Nitrokey/nitrokey-fido2-hardware/fabrication/Assembly/3D_BOT_Fido2.PNG

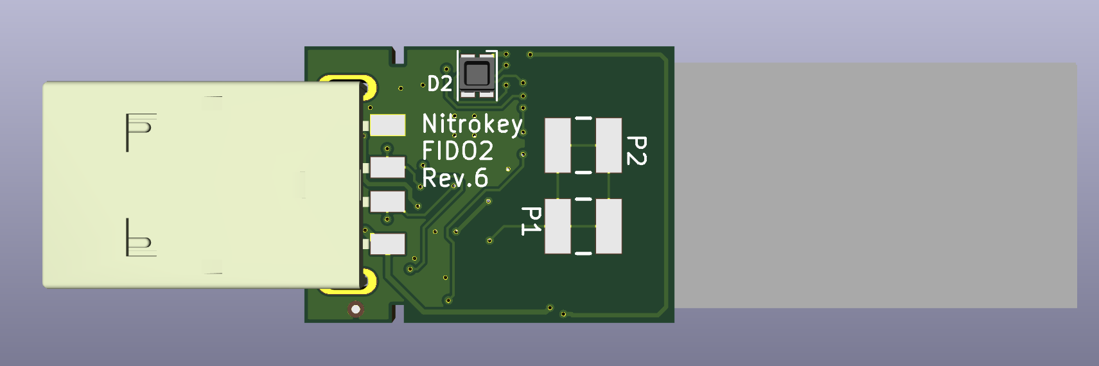
fabrication/Assembly/3D_BOT_Fido2.PNG
