Nitrokey/nitrokey-fido2-hardware/README.md

# nitrokey-fido2-hardware
Hardware layout of the Nitrokey FIDO2

- [nk-fido2-schematic.pdf](https://github.com/Nitrokey/nitrokey-fido2-hardware/blob/master/nk-fido2-schematic.pdf)
- [testpoints](Testpoints.png)

This project is licensed under [CC BY-SA 4.0](https://creativecommons.org/licenses/by-sa/4.0/)
