Nitrokey/nitrokey-fido2-hardware/fabrication/Assembly/nk-fido2-BOM.xlsx

FIDO 2 - BOM:
ID | Quantity | Designator | Footprint | Bezeichnung | Anbieter und Referenz | Comment
1 | 3 | C1,C4,C7 | C_0402_1005Metric | 4.7uF, Tolerance: +/- 10%
2 | 3 | C2,C3,C6 | C_0402_1005Metric | 0.1uF, Tolerance: +/- 10%
3 | 1 | C5 | C_0402_1005Metric | 10n, Tolerance: +/- 10%
4 | 1 | D2 | LED_Cree-PLCC4_2x2mm_CW | CLMVC-FKA-CL1D1L71BB7C3C3 | CLMVC-FKA-CL1D1L71BB7C3C3 (https://www.digikey.de/product-detail/de/cree-inc/CLMVC-FKA-CL1D1L71BB7C3C3/CLMVC-FKA-CL1D1L71BB7C3C3CT-ND/9094273)
5 | 1 | J1 | USB-A-PLUG | USB_Plug | ‎0480372200‎
6 | 1 | L1 | REG_NCP114AMX330TCG_21 | NCP114AMX330TCG | ‎NCP114AMX330TCG‎
7 | 1 | L2 | COIL2_26 | MOLEX_NFC_COIL_1462360101 | 1462360101 | nicht bestücken!
8 | 1 | R2 | R_0402_1005Metric | 10K, Tolerance: +/- 5%
9 | 2 | R3, R7 | R_0402_1005Metric | 4K7, Tolerance: +/- 5% |  | nicht bestücken!
10 | 1 | R4 | R_0402_1005Metric | 68R, Tolerance: +/- 5%
11 | 2 | R5,R1 | R_0402_1005Metric | 4K7, Tolerance: +/- 5%
12 | 1 | R6 | R_0402_1005Metric | 1M, Tolerance: +/- 5%
13 | 1 | U1 | QFN-32-1EP_5x5mm_P0.5mm_EP3.45x3.45mm | STM32L432KCUx | ‎STM32L432KCU6‎
14 | 1 | U2 | SOT-23-6 | MTCH101 | MTCH101-I/OT‎
15 | 1 | U3 | SOT-553 | DF5A5.6JE | DF5A5.6JE,LM‎
16 | 1 | U4 | UDFN-8Pad | ATECC608A |  | nicht bestücken!
17 | 1 | U5 | MLPD3X3_24 | AS3956 | AS3956-ATDM-S4‎ | nicht bestücken!
18 | 2 | P1,P2 | WE-SMGS_3029040030030 | Würth – 3029040030030 | Würth – 3029040030030
