Nitrokey/nitrokey-fido2-hardware/3DLib/CLMVC-FKA-CL1D1L71BB7C3C3.STEP

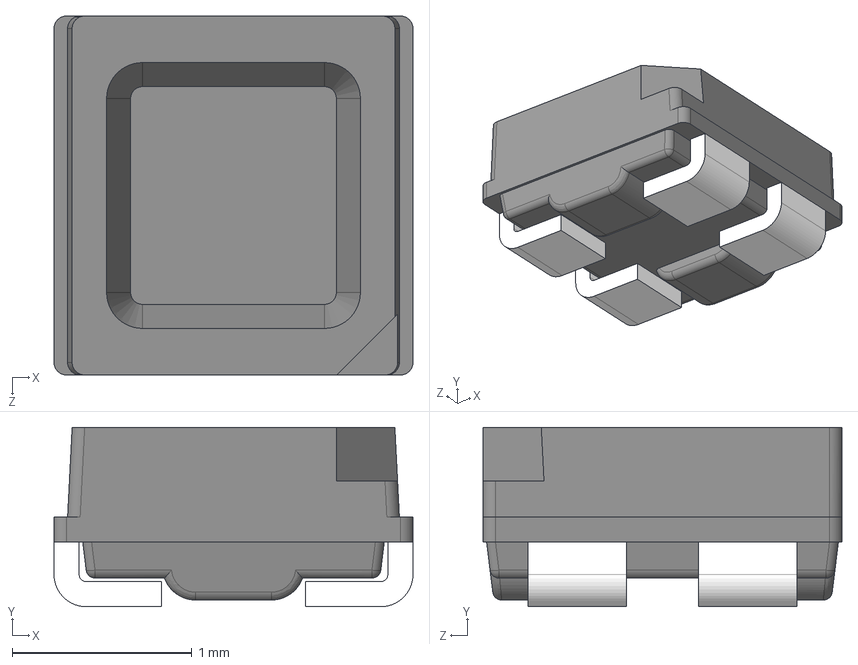
[picture p3: CAD file, 2019-10-14]
3DLib/CLMVC-FKA-CL1D1L71BB7C3C3.STEP
2.00 x 1 x 2.00 mm
