Nitrokey/nitrokey-fido2-hardware/3DLib/1462360101.stp

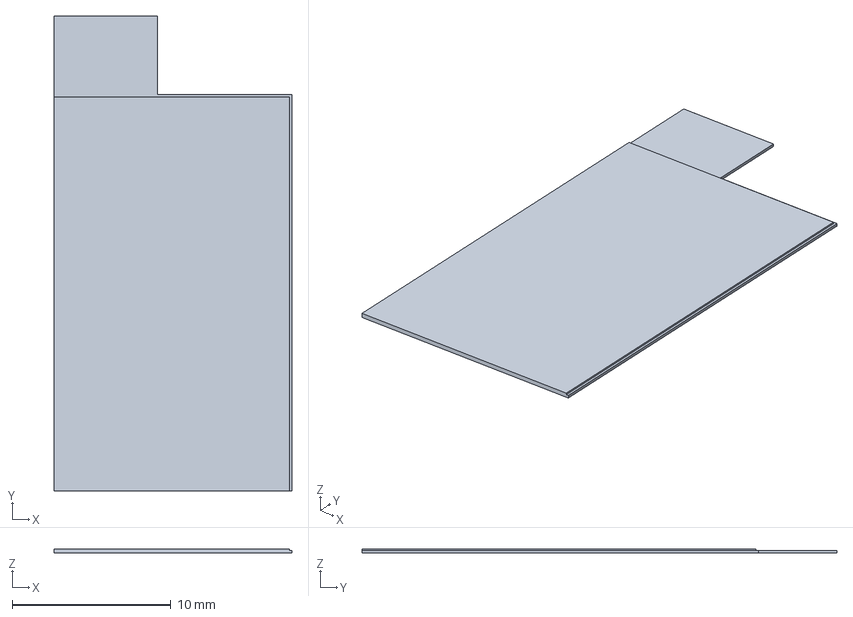
[picture p4: CAD file, 2019-02-20]
3DLib/1462360101.stp
15.0 x 29.9 x 0.27 mm
