Nitrokey/nitrokey-fido2-hardware/nk-fido2-schematic.pdf

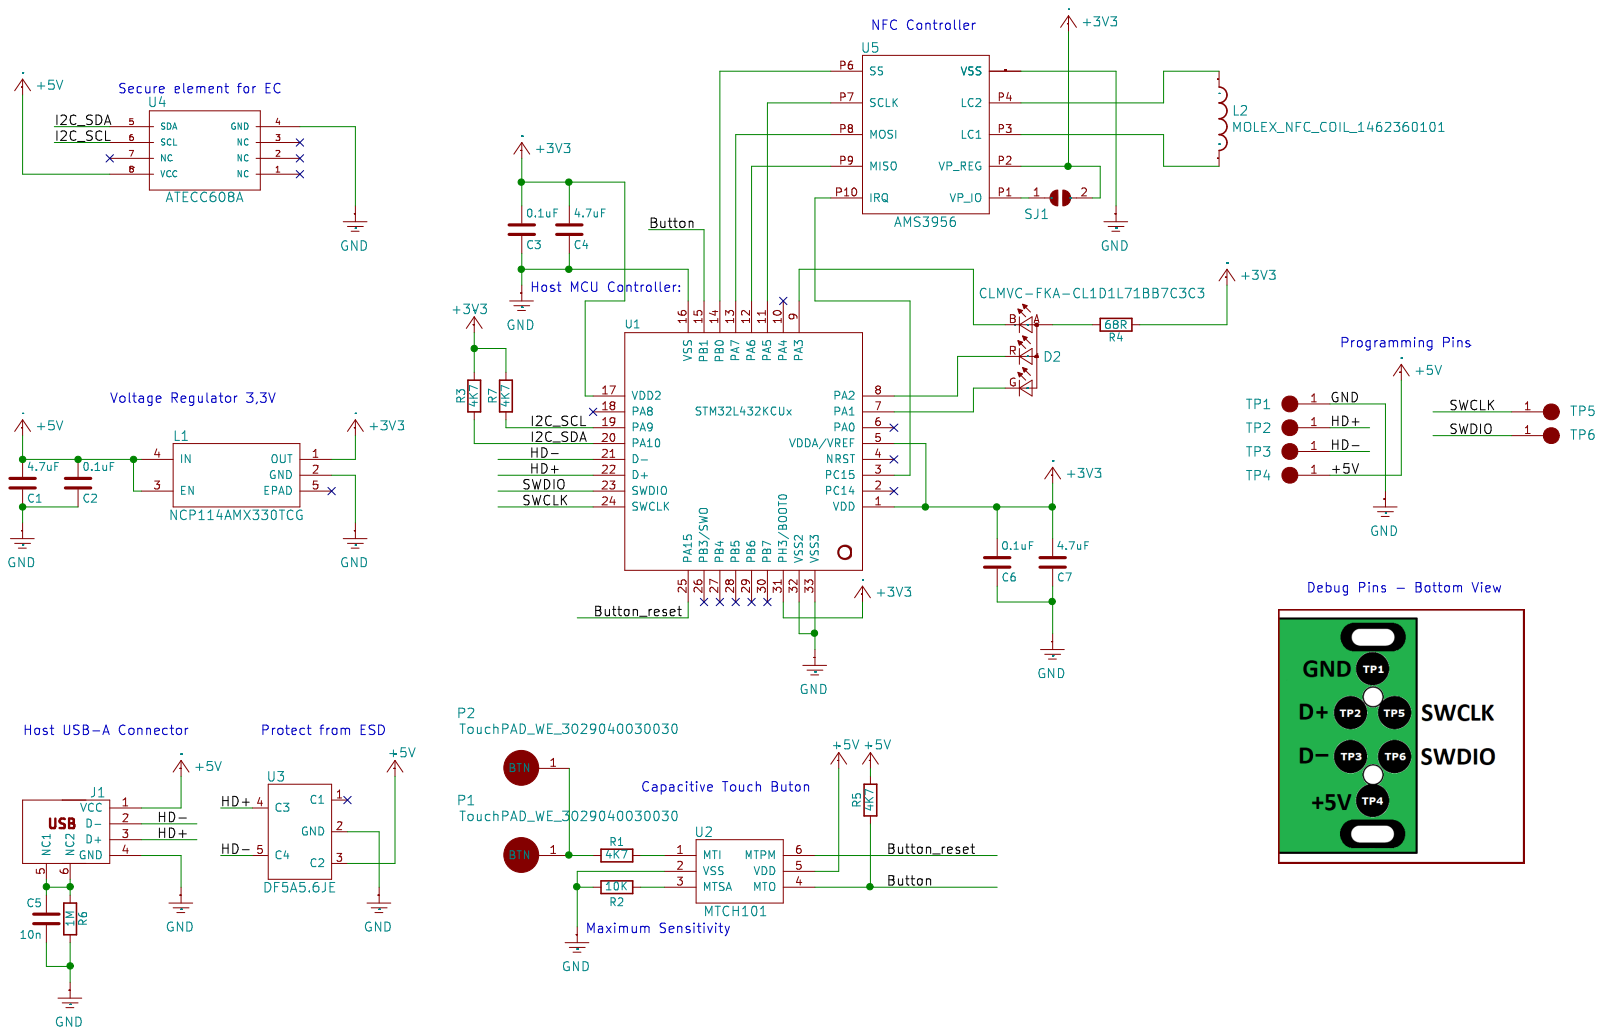
[picture p5: page 1]
