Nitrokey/nitrokey-fido2-hardware/fabrication/Assembly/nk-fido2-Assembly_TOP.pdf

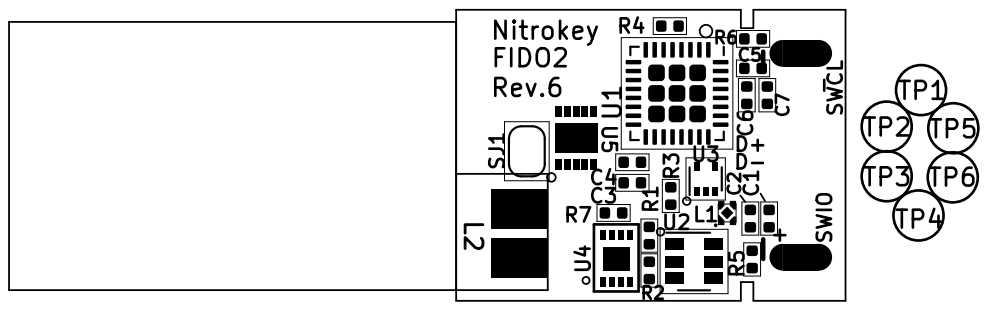
[picture p6: page 1]
