Nitrokey/nitrokey-fido2-hardware/Testpoints.png

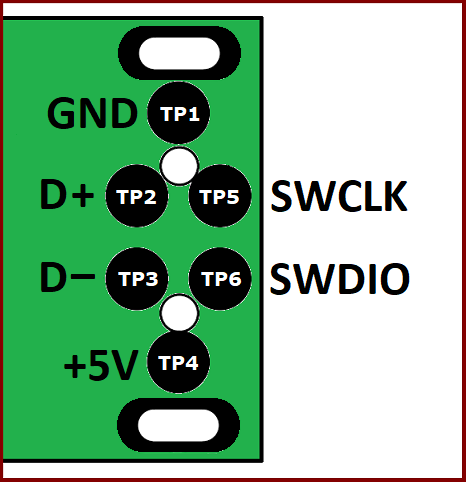
Testpoints.png
