Nitrokey/nitrokey-fido2-hardware/(threads)

Thread 3 (2019-03-29):

Move Pin 1 marking of RGBA LED to proper position

NKelias, 2019-03-29:
Pin 1 Marking on the PCB is currently on the position of Pin 4 on the package.
Alternatively, the anode mark between Pins 1 and 3 on the package might be used as well for alignment.

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

Datasheet: https://everlightamericas.com/index.php?controller=attachment&id_attachment=1010

jans23, 2019-04-12:
Fixed in revision 2.

Closed 2019-04-12.

Thread 4 (2019-03-29):

Correct self-inducement of the touch button

szszszsz, 2019-03-29:
At the moment there is a chance, that the touch button press state would be induced by the blinking of the LED. LED, and/or its power lines, seem to be too close to the touch button plane, thus influencing it. When confirmed with the manual of [MTCH101] (page 9, 7.0 DETECTION DISTANCE), there is this statement:
> No ground plane was near the sensor, as this would give the maximum
detection distance.

At the moment this is worked around in the firmware, by increasing the touch button activation time to 1000 ms (from 500 ms).

Possible solutions:
- moving the LED,
- moving LED's power lines,
- decreasing the size of the touch button plane (optionally moving it to side).

------

Another opinion:
> The datasheet says metal components placed closed to the sensing area could cause this
effect. Actually, touch devices generally requires a "clear" space all
around the sensing area. It means no any metal component should be
closer than a few millimeters, so it is true even for the copper tracks
and therefore the gnd plane. (...)  This can be solved by both hw and sw. The
hw way means a new layout design following the capacitive design
criterias.

[MTCH101]: https://github.com/Nitrokey/nitrokey-fido-u2f-hardware/blob/master/datasheets/Microchip%20MTCH101.pdf

jans23, 2019-04-12:
Hopefully fixed in revision 2. Should be reopened if it still occurs.

Closed 2019-04-12.

Thread 5 (2019-03-29):

Introduce MTPM reset pin to the MCU

szszszsz, 2019-03-29:
Introduce pulled-up MTPM reset pin from the touch controller, to allow the touch button reset from the firmware. Make sure the MTPM is correctly pulled-up (to proper voltage), to avoid noise.

Connected: #4

jans23, 2019-04-12:
Fixed in revision 2.

Closed 2019-04-12.

Thread 7 (2019-09-10):

Wrong LED orientation in 3D view

jans23, 2019-09-10:

jans23, 2019-10-14:
Fixed with commit c38ef88.

Closed 2019-10-14.
