Nitrokey/nitrokey-fido2-hardware/(commit log)

2019-02-20 initial release
    [1462360101.stp, nk-fido2-BOM.xlsx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]
2019-02-21 Add manufacturer refs to BOM
    [nk-fido2-BOM.xlsx]
2019-04-12 Revision 2
    [nk-fido2-BOM.xlsx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]
2019-05-11 Revision 3 with changed button pin and LED moved to the middle-side
    [nk-fido2-B.Mask.gbs, nk-fido2-B.Paste.gbp, nk-fido2-B.SilkS.gbo, nk-fido2-Back.gbl, nk-fido2-Edge.Cuts.gm1, nk-fido2-F.Mask.gts, nk-fido2-F.Paste.gtp, nk-fido2-F.SilkS.gto]
2019-05-22 paste corrected
    [nk-fido2.kicad_pcb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]
2019-06-24 BOM: Clarification which parts not to load
    [nk-fido2-BOM.xlsx]
2019-10-14 Revison 4 with improved touch sensor and new LED
    [CLMVC-FKA-CL1D1L71BB7C3C3.STEP, nk-fido2-BOM.xlsx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]
2019-10-21 Revision 5, component on touch sensor
    [nk-fido2-BOM.xlsx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]
2019-11-20 Fixed inconsistencies in BOM
    [nk-fido2-BOM.xlsx]
2020-04-22 Hardware revision 5a - update to production files. Specific changes: -Change foam pad part number from 2.5mm height to 3mm height -Two foam pads instead of one -Improve silkscreen readability a bit -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
    [nk-fido2-BOM.xlsx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]
2020-06-25 Bump revision to 6, update production files
    [nk-fido2-B_Mask.gbs, nk-fido2-B_Paste.gbp, nk-fido2-B_SilkS.gbo, nk-fido2-Back.gbl, nk-fido2-Edge_Cuts.gm1, nk-fido2-F_Mask.gts, nk-fido2-F_Paste.gtp, nk-fido2-F_SilkS.gto]
